ShifatHossain/CNC-machine/Result pictures/IMG_3405.JPG

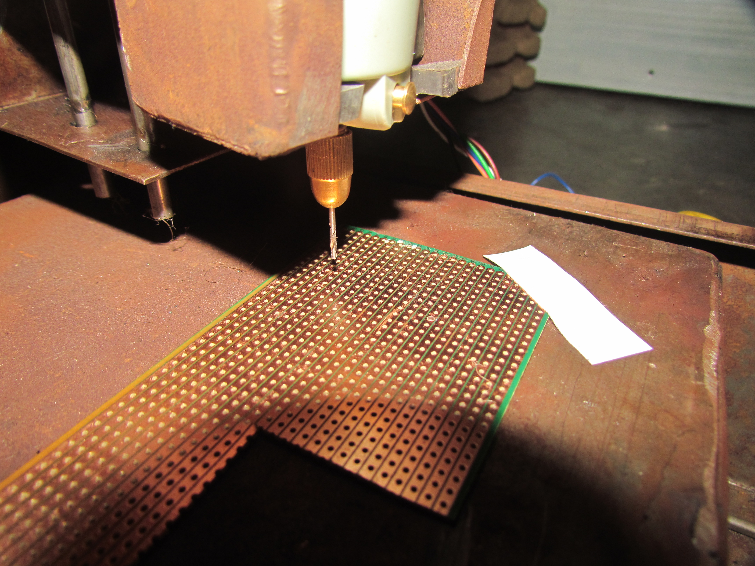
Result pictures/IMG_3405.JPG
