ShifatHossain/CNC-machine/Result pictures/IMG_3406.JPG

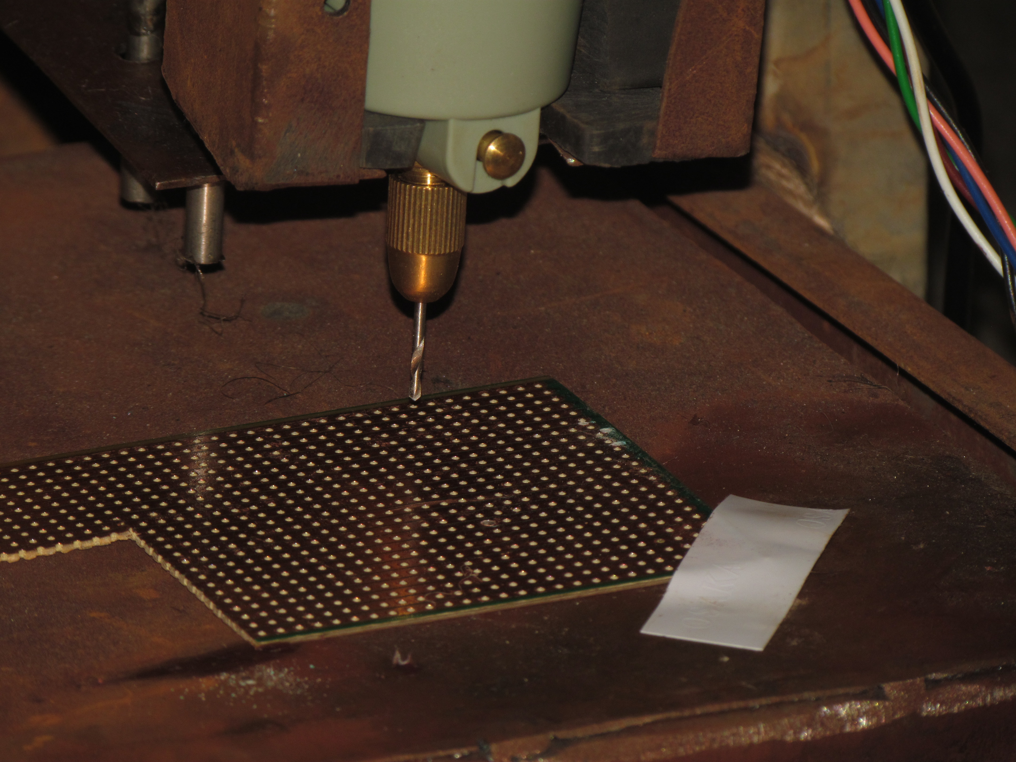
Result pictures/IMG_3406.JPG
