ShifatHossain/CNC-machine/Circuit Diagrams/DRIVER2.JPG

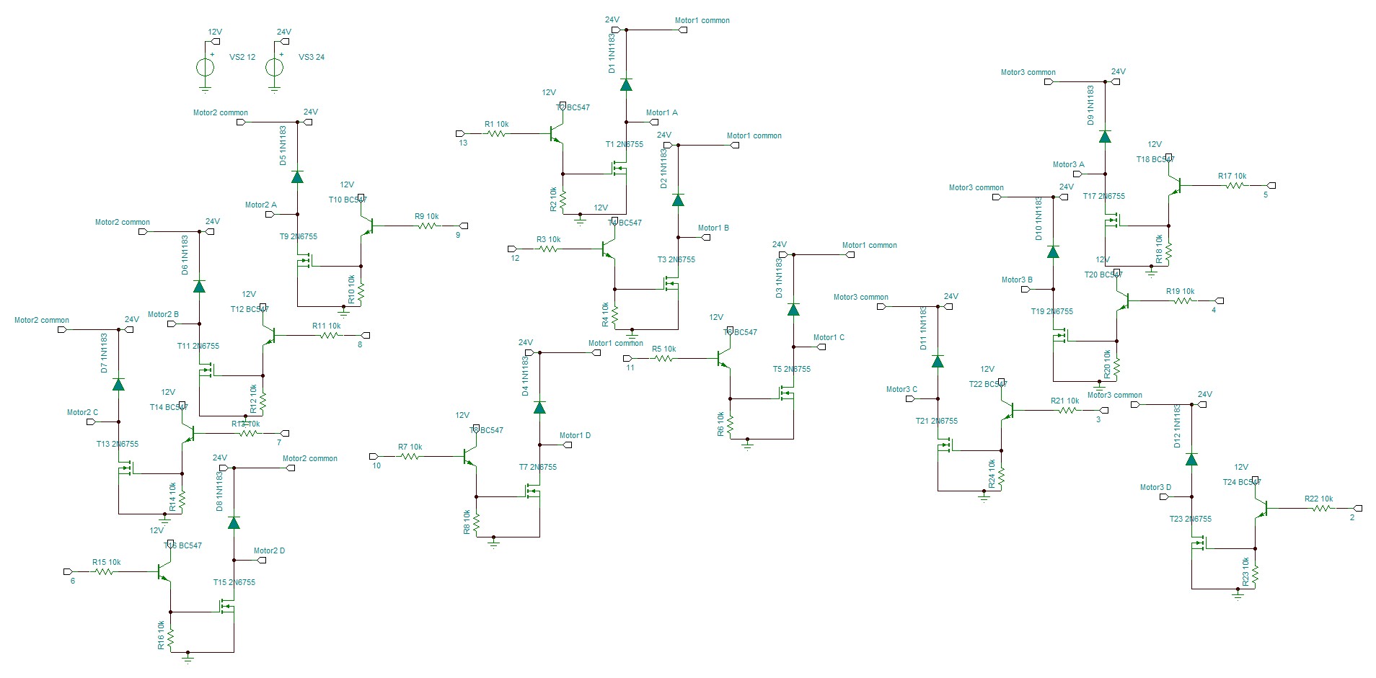
Circuit Diagrams/DRIVER2.JPG
