ShifatHossain/CNC-machine/Result pictures/IMG_3403.JPG

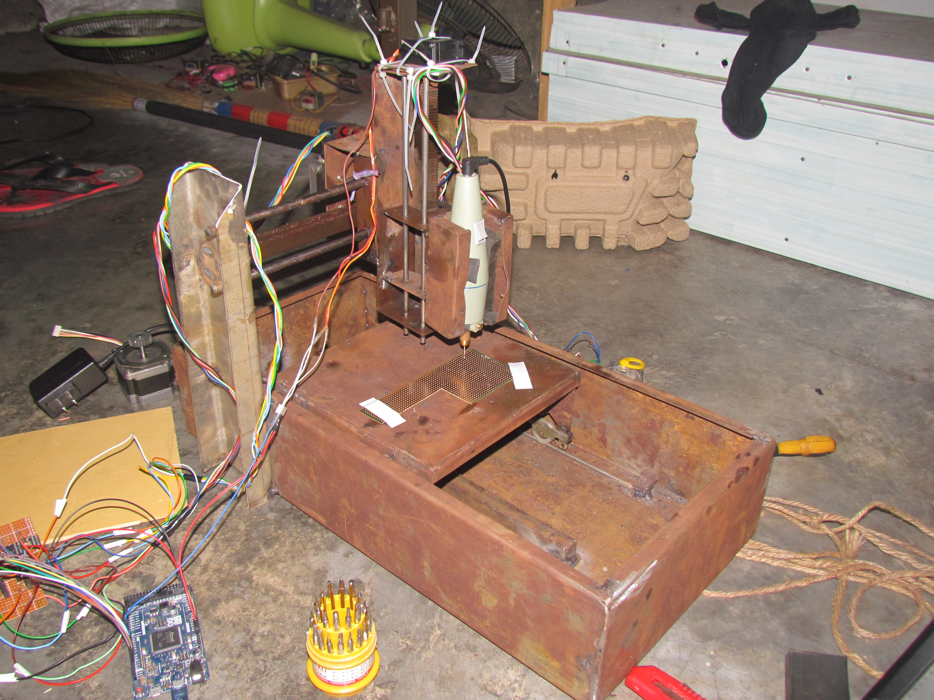
Result pictures/IMG_3403.JPG
