ShifatHossain/CNC-machine/Result pictures/IMG_3404.JPG

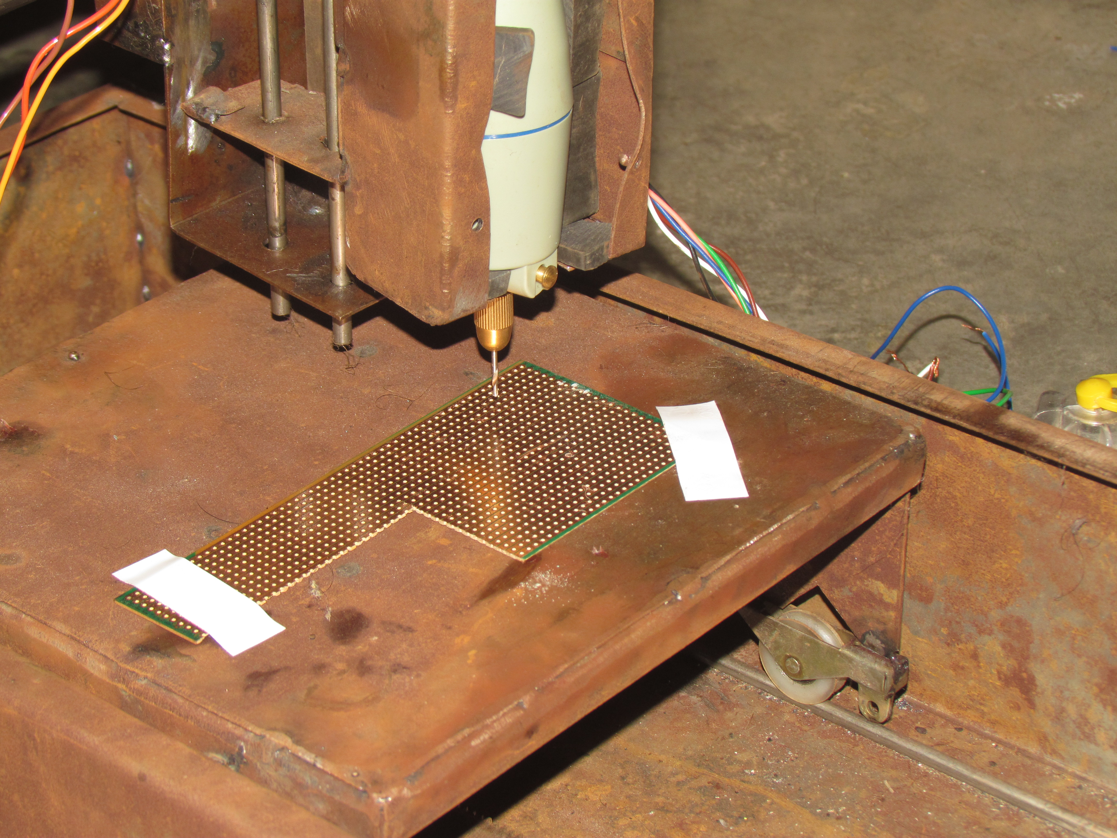
Result pictures/IMG_3404.JPG
