ShifatHossain/CNC-machine/Result pictures/IMG_3407.JPG

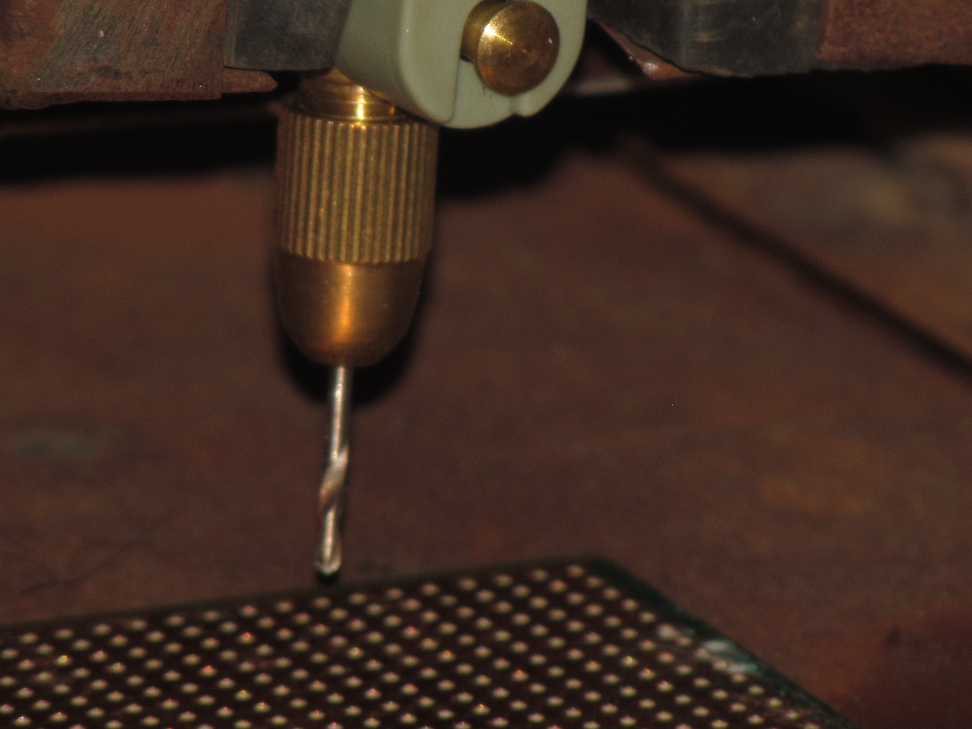
Result pictures/IMG_3407.JPG
