ShifatHossain/CNC-machine/Result pictures/IMG_3408.JPG

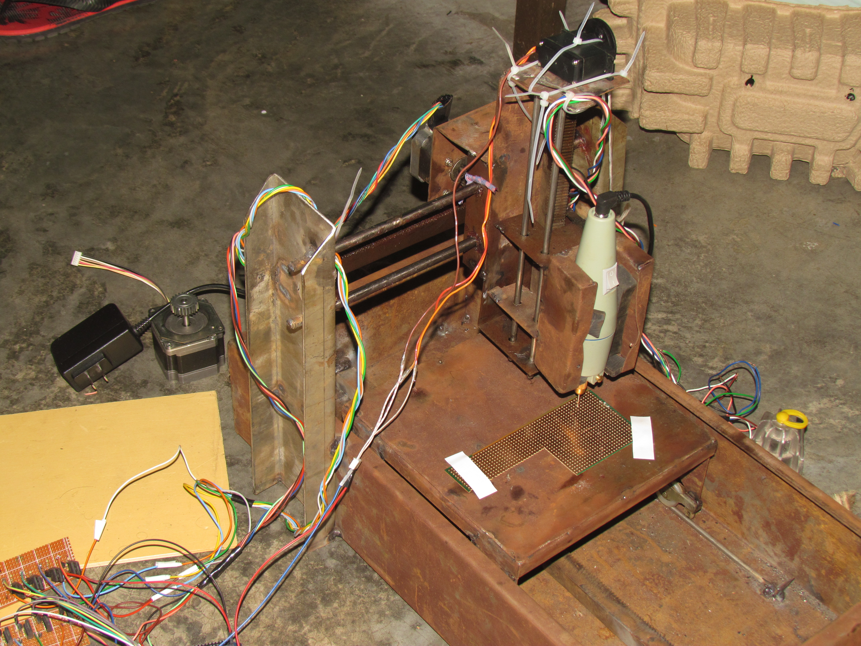
Result pictures/IMG_3408.JPG
