ShifatHossain/CNC-machine/Result pictures/IMG_3409.JPG

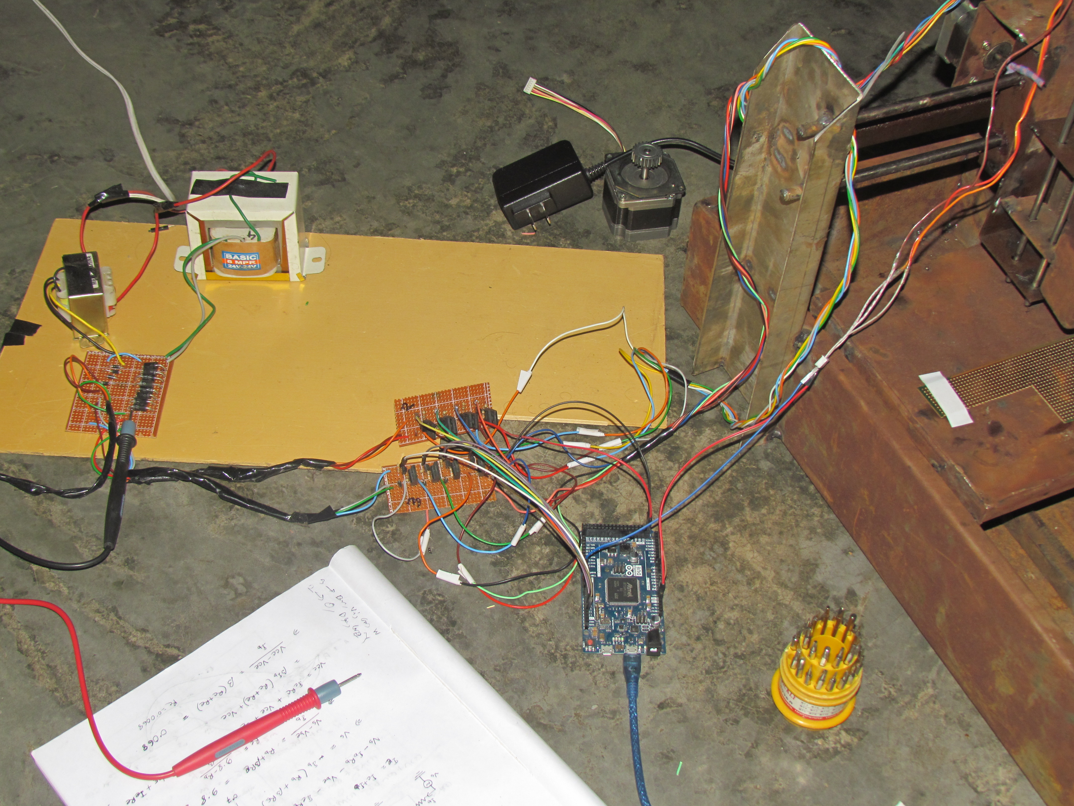
Result pictures/IMG_3409.JPG
