ShifatHossain/CNC-machine/Result pictures/IMG_3413.JPG

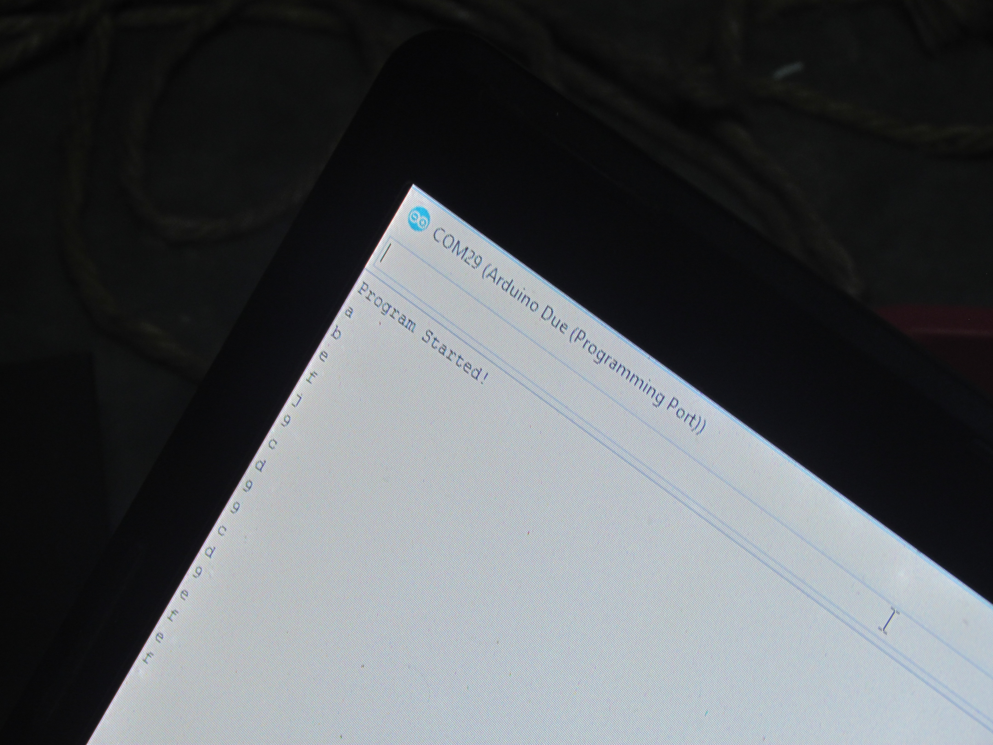
Result pictures/IMG_3413.JPG
